CoffeeTronics/Arduino-Mass-Based-Espresso/Thermistor4cBubbleDisplay_withSignalConditioning/Eagle_Schematic/readMe.txt

Use this schematic with digitalSmooth code
