CoffeeTronics/Arduino-Mass-Based-Espresso/OldCodeFromTestingSections/MeasureVccUsingVrefBubbleDisplay/readMe.txt

This folder is depreciated. 

It was used to measure the Vcc rails of the Arduino's ADC.
This code has been merged into digitalSmooth.
The Vcc rails are measured once during setup().

The menu needs to be adapted to be able to run the Vcc Measurement periodically and
on demand.
