CoffeeTronics/Arduino-Mass-Based-Espresso/OldCodeFromTestingSections/LM35_TempReferenceBubbleDisplay/LM35_TempReferenceBubbleDisplay/readMe.txt

Use this code to calibrate the thermistor. The LM35 is guaranteed to be +/-0.5C 
(typically +/-0.2C) at 25C and +/-0.75C over full range (-55C to 150C)
