CoffeeTronics/Arduino-Mass-Based-Espresso/HX711_Brew_Switch_Preinfusion_Measure_Mass/HX711_BrewSwitchSense_Preinfusion.pdf

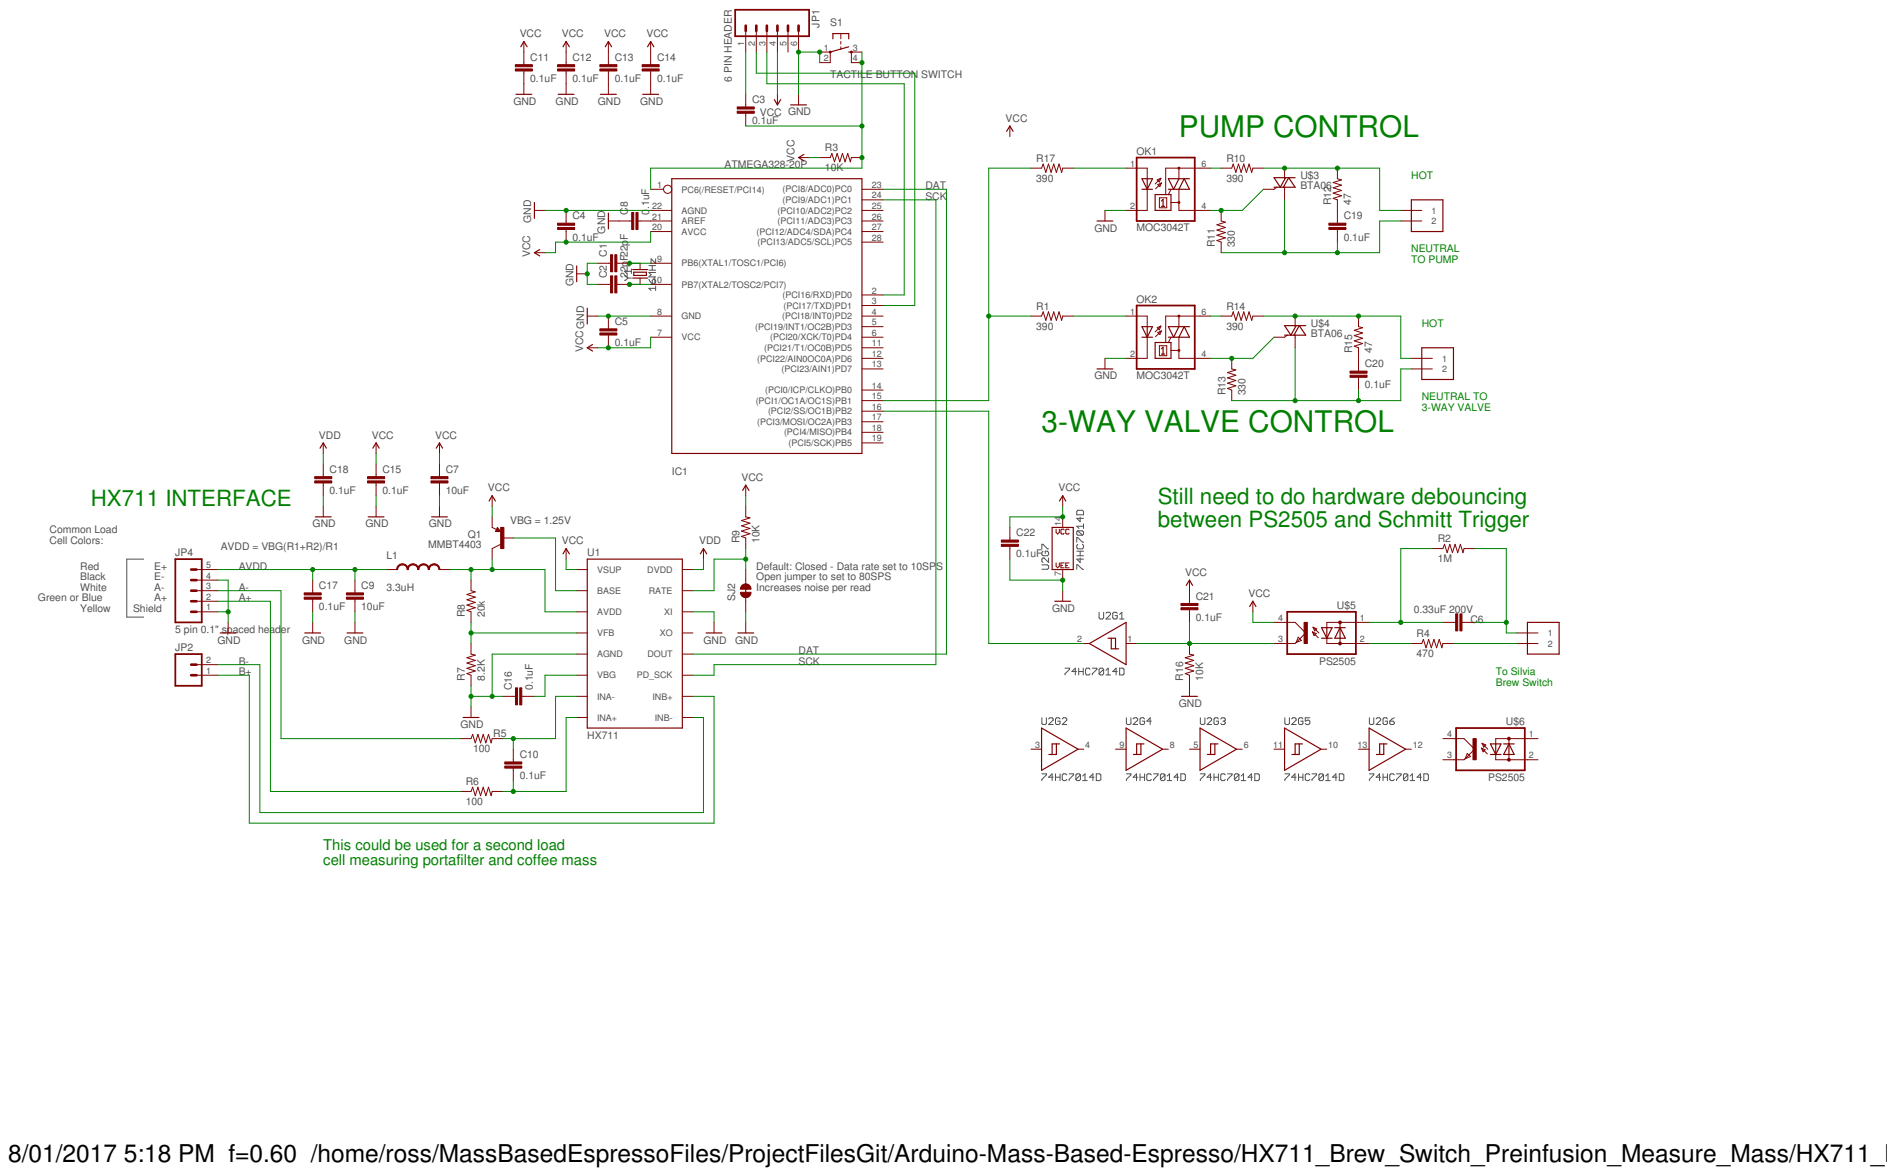
[picture p1: page 1]

VCC GND GND GND GND GND

HOT NEUTRAL TO PUMP HOT

Still need to do hardware debouncing
between PS2505 and Schmitt Trigger

Increases noise per read E+E- A- A+ Red Black White Green or Blue

To Silvia Brew Switch

This could be used for a second load
cell measuring portafilter and coffee mass

8/01/2017 5:18 PM f=0.60 /home/ross/MassBasedEspressoFiles/ProjectFilesGit/Arduino-Mass-Based-Espresso/HX711_Brew_Switch_Preinfusion_Measure_Mass/HX711_BrewSwitchSense_Preinfusion.sch (Sheet: 1/1)
