CoffeeTronics/Arduino-Mass-Based-Espresso/Thermistor4cBubbleDisplay_withSignalConditioning/Eagle_Schematic/BubbleDisplayTempSensingThermistorWithRCfilterOpampSignalConditioning.pdf

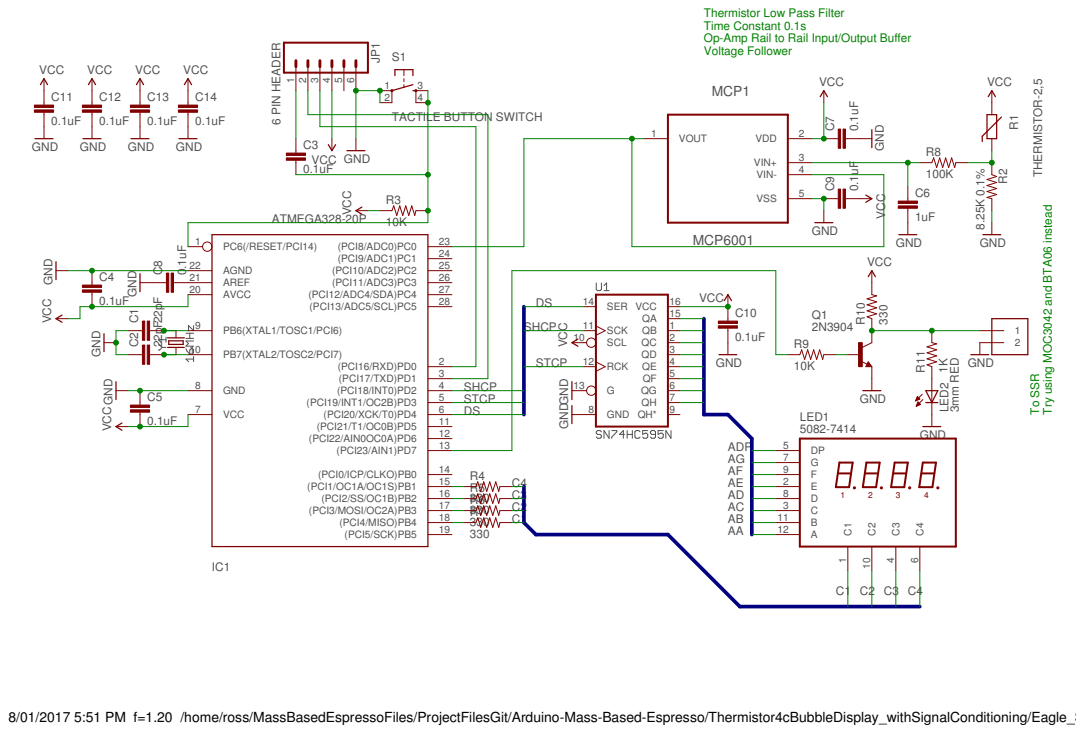
[picture p2: page 1]

Thermistor Low Pass Filter
Time Constant 0.1s
Op-Amp Rail to Rail Input/Output Buffer
Voltage Follower

8/01/2017 5:51 PM f=1.20 /home/ross/MassBasedEspressoFiles/ProjectFilesGit/Arduino-Mass-Based-Espresso/Thermistor4cBubbleDisplay_withSignalConditioning/Eagle_Schematic/BubbleDisplayTempSensingThermistorWithRCfilterOpampSignalConditioning.sch (Sheet: 1/1)
