CoffeeTronics/Arduino-Mass-Based-Espresso/RotaryEncoderLCDMenu/src/Arduino_Rotary_Encoder_Lcd_ADD-DS3231.pdf

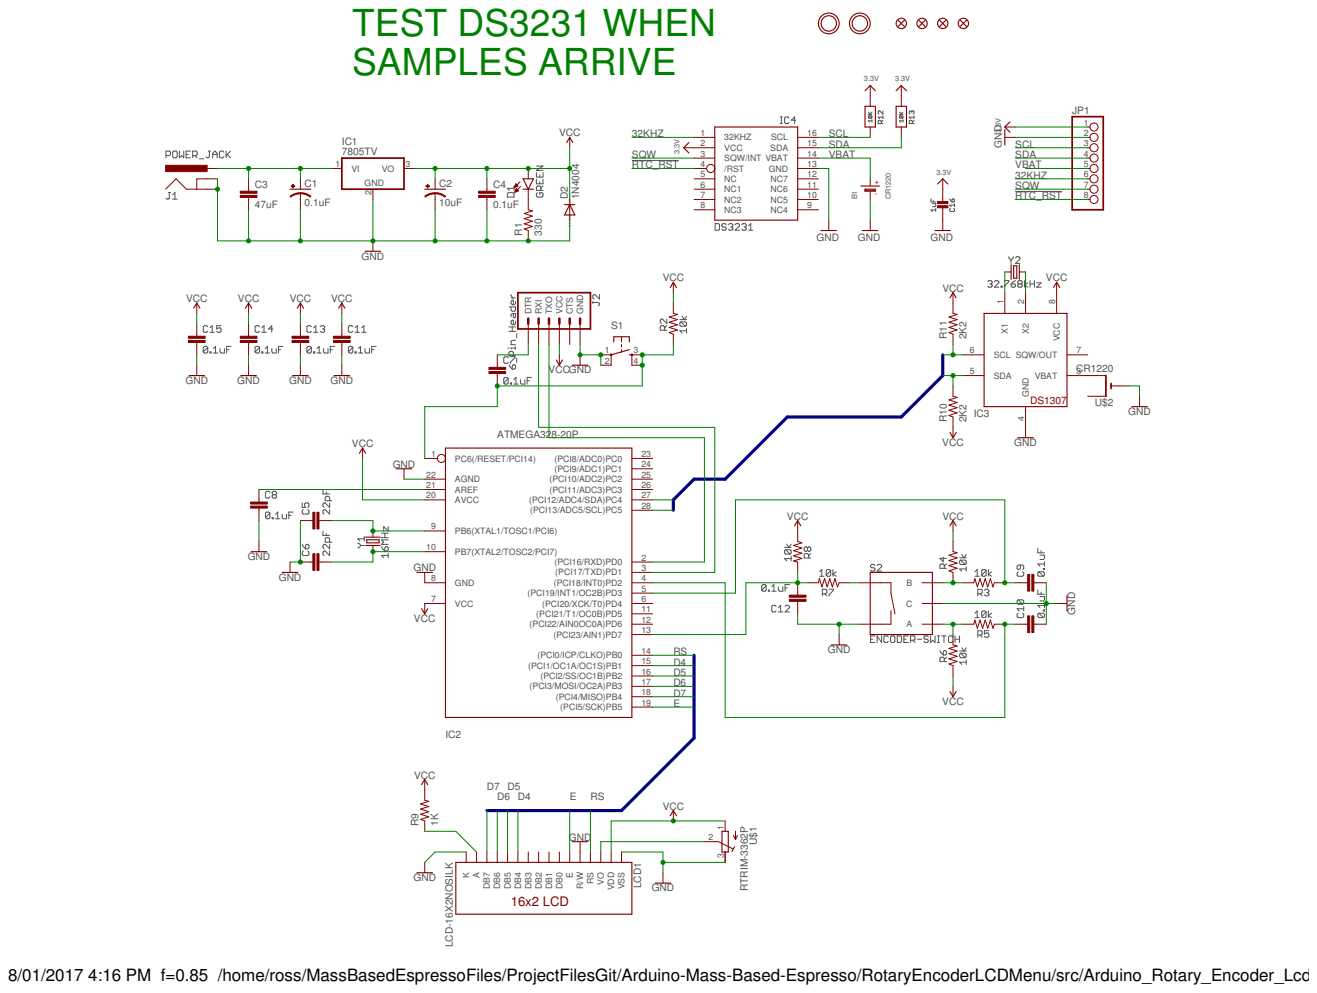
[picture p3: page 1]

8/01/2017 4:16 PM f=0.85 /home/ross/MassBasedEspressoFiles/ProjectFilesGit/Arduino-Mass-Based-Espresso/RotaryEncoderLCDMenu/src/Arduino_Rotary_Encoder_Lcd_ADD-DS3231.sch (Sheet: 1/1)
