CoffeeTronics/Arduino-Mass-Based-Espresso/DATASHEETS_APPLICATION_NOTES/SparkFun_HX711_Load_Cell_v11/SparkFun_HX711_Load_Cell_v11.brd

## EAGLE design DATASHEETS_APPLICATION_NOTES/SparkFun_HX711_Load_Cell_v11/SparkFun_HX711_Load_Cell_v11.brd (2017-01-08)

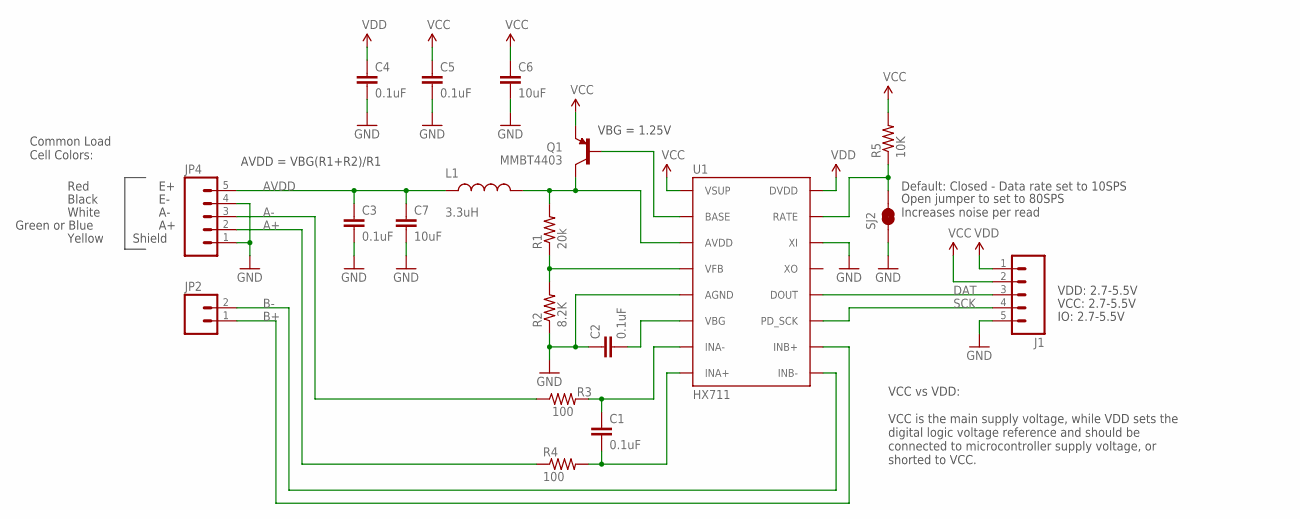
[picture p4: schematic HX711_Sparkfun.sch]

Parts:
C1, C2, C3, C4, C5: 0.1uF; 0603-CAP
C6, C7: 10uF; 1210
J1: M05PTH; 1X05
JP2: M02PTH; 1X02
JP4: M05PTH; 1X05
L1: 3.3uH; 0805
Q1: MMBT4403; SOT23-3
R1: 20k; 0603-RES
R2: 8.2K; 0603-RES
R3, R4: 100; 0603-RES
R5: 10K; 0603-RES
SJ2: JUMPER-PAD-2-NC_BY_TRACE; PAD-JUMPER-2-NC_BY_TRACE_YES_SILK
U1: HX711; SO16

Connections:
A+: JP4.2, R4.1
A-: JP4.3, R3.1
AVDD: C3.1, C7.1, JP4.5, L1.1
B+: JP2.1, U1.10 (INB+)
B-: JP2.2, U1.9 (INB-)
DAT: J1.3, U1.12 (DOUT)
GND: C2.1, C3.2, C4.2, C5.2, C6.2, C7.2, J1.5, JP4.1, JP4.4, R2.1, SJ2.1, U1.5 (AGND), U1.14 (XI)
unnamed: R5.1, SJ2.2, U1.15 (RATE)
unnamed: C1.1, R3.2, U1.7 (INA-)
unnamed: C1.2, R4.2, U1.8 (INA+)
unnamed: Q1.1 (B), U1.2 (BASE)
unnamed: L1.2, Q1.3 (C), R1.2, U1.3 (AVDD)
unnamed: R1.1, R2.2, U1.4 (VFB)
unnamed: C2.2, U1.6 (VBG)
SCK: J1.4, U1.11 (PD_SCK)
VCC: C5.1, C6.1, J1.2, Q1.2 (E), R5.2, U1.1 (VSUP)
VDD: C4.1, J1.1, U1.16 (DVDD)

Notes on the sheet:
VCC: 2.7-5.5V
VBG = 1.25V
AVDD = VBG(R1+R2)/R1
Default: Closed - Data rate set to 10SPS
Open jumper to set to 80SPS Increases noise per read
Red
Black
White
Green or Blue
Common Load Cell Colors:
IO: 2.7-5.5V
Shield
Yellow
VDD: 2.7-5.5V
VCC vs VDD: VCC is the main supply voltage, while VDD sets the digital logic voltage reference and should be connected to microcontroller supply voltage, or shorted to VCC.



Board: 2 copper layers, 30.5 x 22.9 mm, 30 parts (4 on the bottom side), 17 nets.

Other parts of the board:
FID1, FID2: FIDUCIAL1X2; FIDUCIAL-1X2
FRAME1: FRAME-LETTER; CREATIVE_COMMONS
LOGO1: SFE_LOGO_NAME_FLAME.1_INCH; SFE_LOGO_NAME_FLAME_.1
LOGO3: SFE_LOGO_FLAME.1_INCH; SFE_LOGO_FLAME_.1
STANDOFF1, STANDOFF2, STANDOFF3, STANDOFF4: STAND-OFF
U7: OSHW-LOGOS; OSHW-LOGO-S
U$1: REVISION
