CoffeeTronics/Arduino-Mass-Based-Espresso/HX711_Brew_Switch_Preinfusion_Measure_Mass/HX711_BrewSwitchSense_Preinfusion.sch

## EAGLE design HX711_Brew_Switch_Preinfusion_Measure_Mass/HX711_BrewSwitchSense_Preinfusion.sch (2017-01-09)

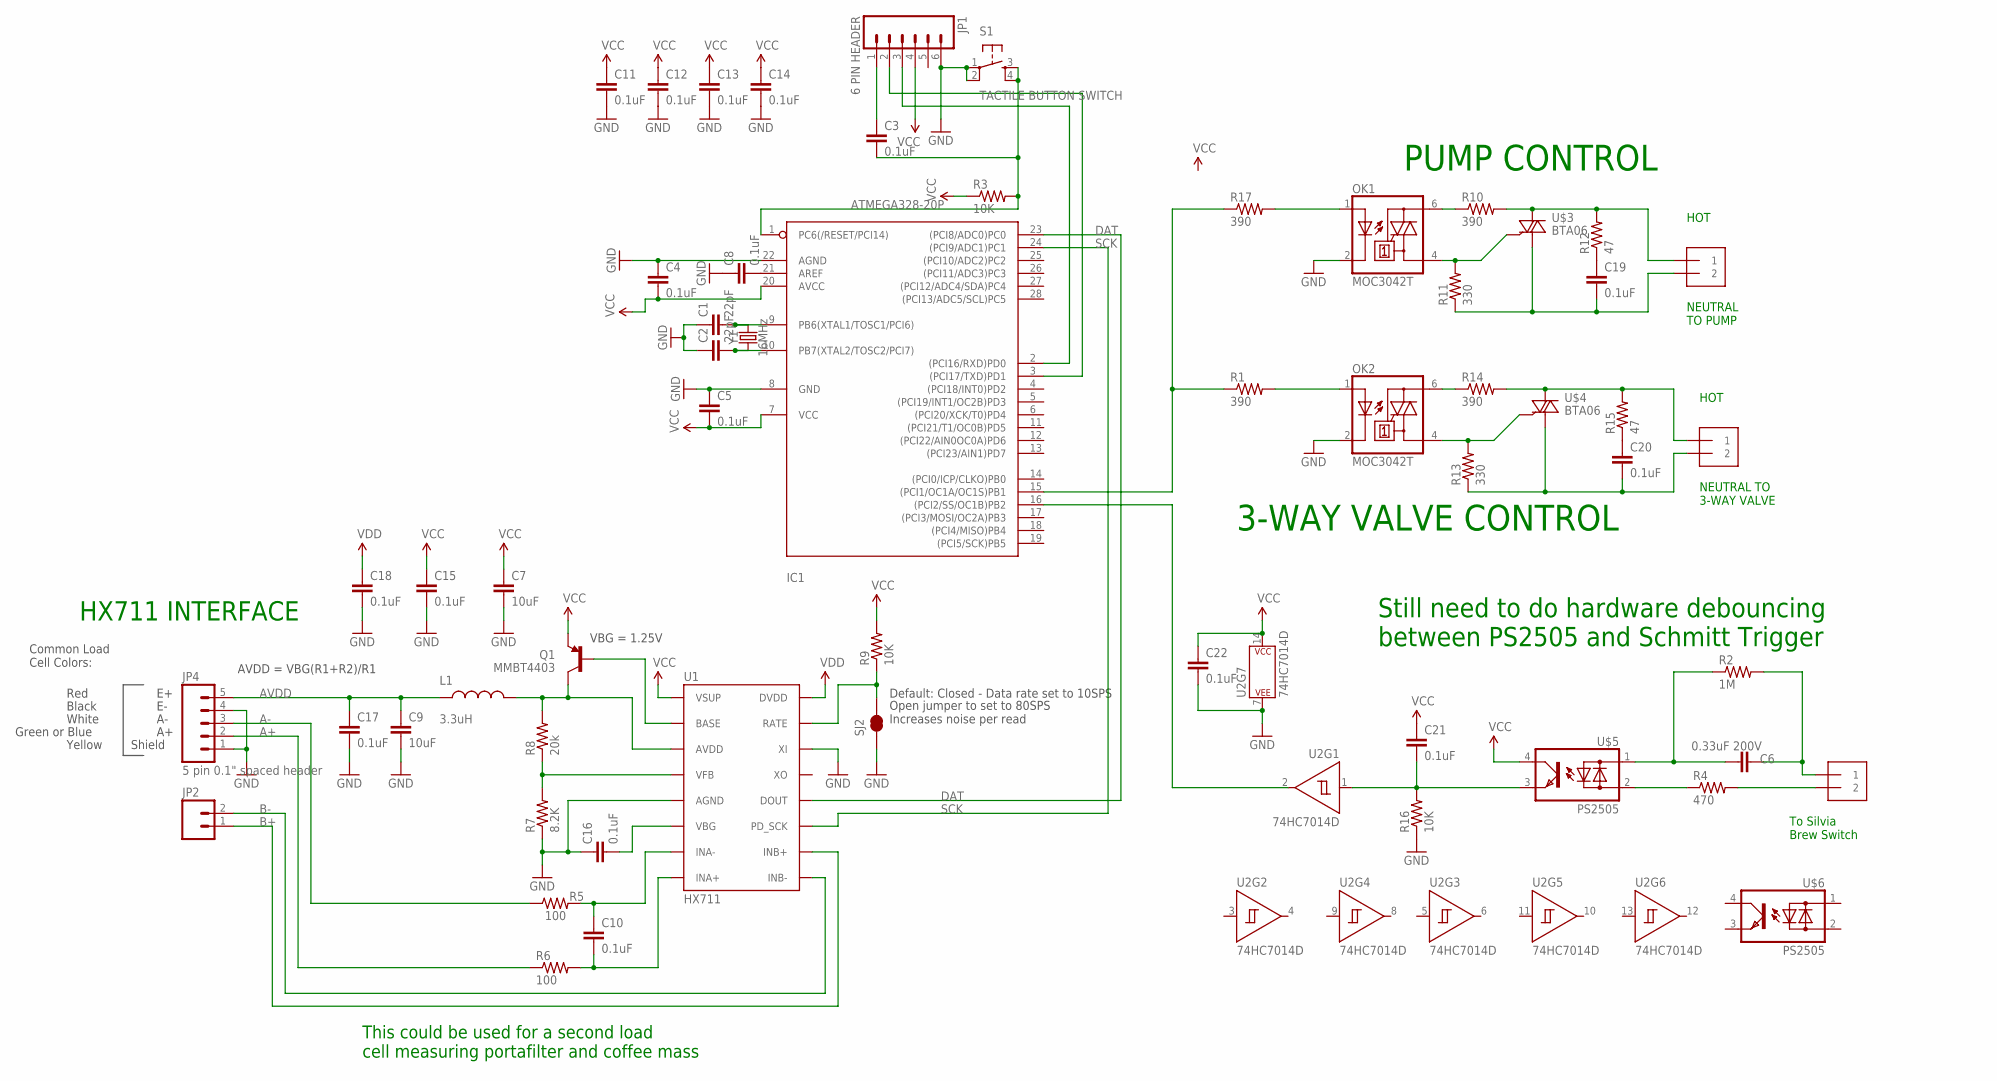
[picture p7: schematic HX711_BrewSwitchSense_Preinfusion.sch]

Parts:
C1, C2: 22pF; CAP-PTH-SMALL-KIT
C3, C4, C5, C8, C11, C12, C13, C14, C19, C20, C21, C22: 0.1uF; CAP-PTH-SMALLEZ
C6: 0.33uF 200V; C15B6
C7, C9: 10uF; 1210
C10, C15, C16, C17, C18: 0.1uF; 0603-CAP
IC1: ATMEGA328-20P; DIL28-3
J2, J3, J4: 1X2-3.5MM
JP1: 6 PIN HEADER; 1X06_LOCK_LONGPADS
JP2: M02PTH; 1X02
JP4: 5 pin 0.1" spaced header; 1X05
L1: 3.3uH; 0805
OK1, OK2: MOC3042T; DIL06B
Q1: MMBT4403; SOT23-3
R1, R10, R14, R17: 390; AXIAL-0.5
R2: 1M; 1/6W-RES
R3, R16: 10K; AXIAL-0.5
R4: 470; AXIAL-0.3-KIT
R5, R6: 100; 0603-RES
R7: 8.2K; 0603-RES
R8: 20k; 0603-RES
R9: 10K; 0603-RES
R11, R13: 330; AXIAL-0.5
R12, R15: 47; AXIAL-0.5
S1: TACTILE BUTTON SWITCH; TACTILE-PTH
SJ2: JUMPER-PAD-2-NC_BY_TRACE; PAD-JUMPER-2-NC_BY_TRACE_YES_SILK
U1: HX711; SO16
U2: 74HC7014D; SO14
U$3, U$4: BTA06; TO220V
U$5, U$6: PS2505; DIL04
Y1: 16MHz; HC49US

Connections:
A+: JP4.2, R6.1
A-: JP4.3, R5.1
AVDD: C9.1, C17.1, JP4.5, L1.1
B+: JP2.1, U1.10 (INB+)
B-: JP2.2, U1.9 (INB-)
DAT: IC1.23 ((PCI8/ADC0)PC0), U1.12 (DOUT)
GND: C1.1, C2.1, C4.1, C5.1, C7.2, C8.1, C9.2, C11.2, C12.2, C13.2, C14.2, C15.2, C16.1, C17.2, C18.2, C22.2, IC1.8 (GND), IC1.22 (AGND), JP1.6, JP4.1, JP4.4, OK1.2 (C), OK2.2 (C), R7.1, R16.P$1 (1), S1.1, S1.2, SJ2.1, U1.5 (AGND), U1.14 (XI), U2.7 (P$V-)
unnamed: C3.1, JP1.1
unnamed: OK2.1 (A), R1.P$2 (2)
unnamed: C3.2, IC1.1 (PC6(/RESET/PCI14)), R3.P$2 (2), S1.3, S1.4
unnamed: C8.2, IC1.21 (AREF)
unnamed: C1.2, IC1.9 (PB6(XTAL1/TOSC1/PCI6)), Y1.2
unnamed: C2.2, IC1.10 (PB7(XTAL2/TOSC2/PCI7)), Y1.1
unnamed: C6.1, R2.1, U$5.1 (AC1)
unnamed: C6.2, J2.1, R2.2
unnamed: IC1.3 ((PCI17/TXD)PD1), JP1.2
unnamed: IC1.2 ((PCI16/RXD)PD0), JP1.3
unnamed: R4.P$1 (1), U$5.2 (AC2)
unnamed: J2.2, R4.P$2 (2)
unnamed: Q1.1 (B), U1.2 (BASE)
unnamed: R7.2, R8.1, U1.4 (VFB)
unnamed: C16.2, U1.6 (VBG)
unnamed: L1.2, Q1.3 (C), R8.2, U1.3 (AVDD)
unnamed: R9.1, SJ2.2, U1.15 (RATE)
unnamed: C10.1, R5.2, U1.7 (INA-)
unnamed: C10.2, R6.2, U1.8 (INA+)
unnamed: IC1.15 ((PCI1/OC1A/OC1S)PB1), R1.P$1 (1), R17.P$1 (1)
unnamed: OK1.6 (A2), R10.P$1 (1)
unnamed: J3.1, R10.P$2 (2), R12.P$2 (2), U$3.2 (A2)
unnamed: OK1.4 (A1), R11.P$2 (2), U$3.3 (G)
unnamed: C19.2, J3.2, R11.P$1 (1), U$3.1 (A1)
unnamed: C19.1, R12.P$1 (1)
unnamed: C20.1, R15.P$1 (1)
unnamed: OK2.6 (A2), R14.P$1 (1)
unnamed: J4.1, R14.P$2 (2), R15.P$2 (2), U$4.2 (A2)
unnamed: OK2.4 (A1), R13.P$2 (2), U$4.3 (G)
unnamed: C20.2, J4.2, R13.P$1 (1), U$4.1 (A1)
unnamed: C21.2, R16.P$2 (2), U2.1 (A), U$5.3 (E)
unnamed: IC1.16 ((PCI2/SS/OC1B)PB2), U2.2 (Y)
unnamed: OK1.1 (A), R17.P$2 (2)
SCK: IC1.24 ((PCI9/ADC1)PC1), U1.11 (PD_SCK)
VCC: C4.2, C5.2, C7.1, C11.1, C12.1, C13.1, C14.1, C15.1, C21.1, C22.1, IC1.7 (VCC), IC1.20 (AVCC), JP1.4, Q1.2 (E), R3.P$1 (1), R9.2, U1.1 (VSUP), U2.14 (P$V+), U$5.4 (C)
VDD: C18.1, U1.16 (DVDD)

Notes on the sheet:
To Silvia Brew Switch
VBG = 1.25V
AVDD = VBG(R1+R2)/R1
Default: Closed - Data rate set to 10SPS
Open jumper to set to 80SPS Increases noise per read
Red
Black
White
Green or Blue
Common Load Cell Colors:
Shield
Yellow
HX711 INTERFACE
HOT
NEUTRAL TO PUMP
PUMP CONTROL
3-WAY VALVE CONTROL
This could be used for a second load cell measuring portafilter and coffee mass
Still need to do hardware debouncing between PS2505 and Schmitt Trigger
NEUTRAL TO 3-WAY VALVE
