CoffeeTronics/Arduino-Mass-Based-Espresso/LM35_TempReferenceBubbleDisplay/LM35_TempReferenceBubbleDisplay/LM35BubbleDisplayTempCalibration.sch

## EAGLE design LM35_TempReferenceBubbleDisplay/LM35_TempReferenceBubbleDisplay/LM35BubbleDisplayTempCalibration.sch (2016-12-26)

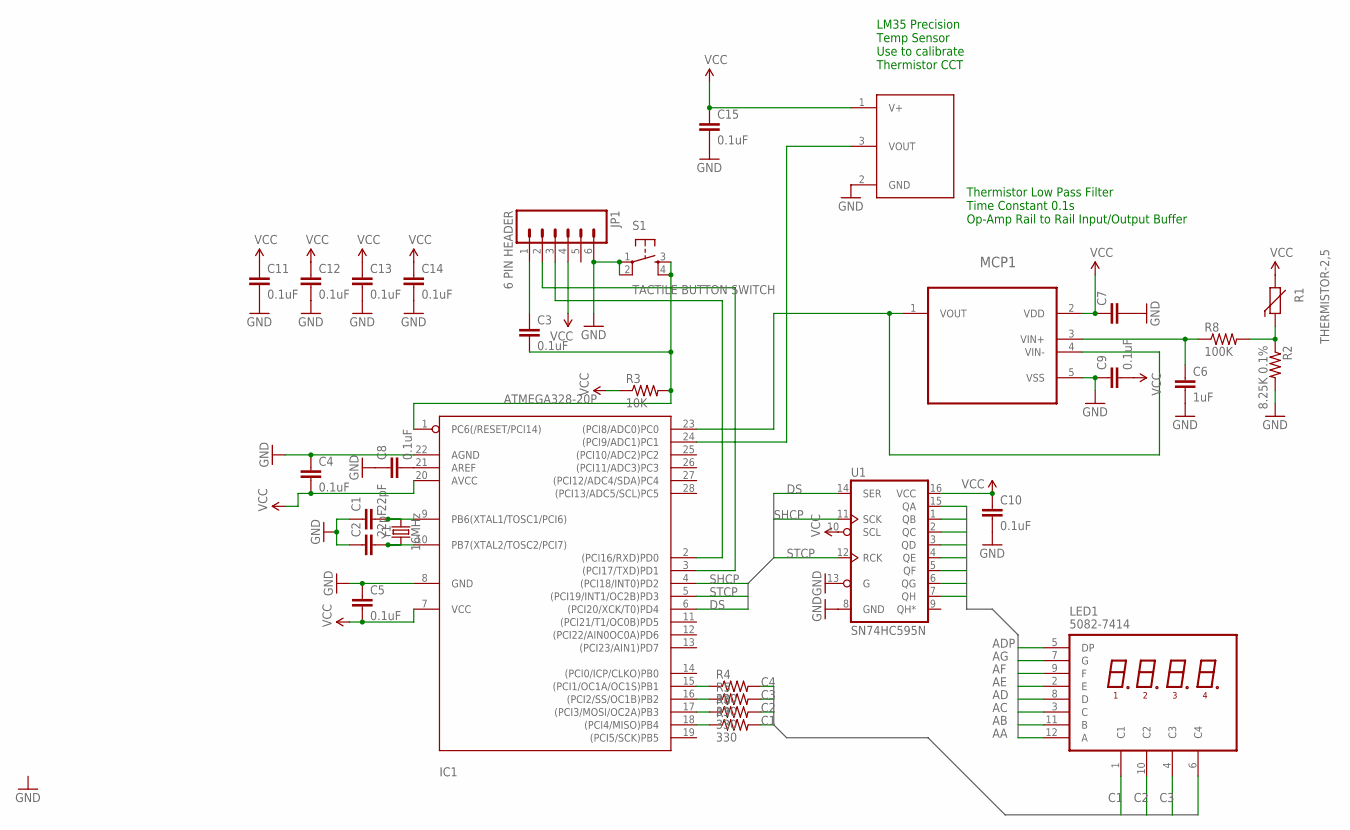
[picture p8: schematic LM35BubbleDisplayTempCalibration.sch]

Parts:
C1, C2: 22pF; CAP-PTH-SMALL-KIT
C3, C4, C5, C8, C9, C10, C11, C12, C13, C14, C15: 0.1uF; CAP-PTH-SMALLEZ
C6: 1uF; CAP-PTH-SMALLEZ
C7: CAPEZ; CAP-PTH-SMALLEZ
IC1: ATMEGA328-20P; DIL28-3
JP1: 6 PIN HEADER; 1X06_LOCK_LONGPADS
LED1: 5082-7414
MCP1: MCP6001R
R1: THERMISTOR-2,5; RS-2,5
R2: 8.25K 0.1%; AXIAL-0.5
R3: 10K; AXIAL-0.5
R4, R5, R6, R7: 330; AXIAL-0.5
R8: 100K; AXIAL-0.5
S1: TACTILE BUTTON SWITCH; TACTILE-PTH
U1: SN74HC595N; DIP16
U$1: LM35; TO220V
Y1: 16MHz; HC49US

Connections:
AA: LED1.12 (A), U1.15 (QA)
AB: LED1.11 (B), U1.1 (QB)
AC: LED1.3 (C), U1.2 (QC)
AD: LED1.8 (D), U1.3 (QD)
ADP: LED1.5 (DP), U1.7 (QH)
AE: LED1.2 (E), U1.4 (QE)
AF: LED1.9 (F), U1.5 (QF)
AG: LED1.7 (G), U1.6 (QG)
C1: LED1.1 (C1), R7.P$2 (2)
C2: LED1.10 (C2), R6.P$2 (2)
C3: LED1.4 (C3), R5.P$2 (2)
C4: LED1.6 (C4), R4.P$2 (2)
DS: IC1.6 ((PCI20/XCK/T0)PD4), U1.14 (SER)
GND: C1.1, C2.1, C4.1, C5.1, C6.2, C7.2, C8.1, C9.1, C10.2, C11.2, C12.2, C13.2, C14.2, C15.2, IC1.8 (GND), IC1.22 (AGND), JP1.6, MCP1.5 (VSS), R2.P$2 (2), S1.1, S1.2, U1.8 (GND), U1.13 (G), U$1.2 (GND)
unnamed: C3.1, JP1.1
unnamed: IC1.15 ((PCI1/OC1A/OC1S)PB1), R4.P$1 (1)
unnamed: C3.2, IC1.1 (PC6(/RESET/PCI14)), R3.P$2 (2), S1.3, S1.4
unnamed: C8.2, IC1.21 (AREF)
unnamed: C1.2, IC1.9 (PB6(XTAL1/TOSC1/PCI6)), Y1.2
unnamed: C2.2, IC1.10 (PB7(XTAL2/TOSC2/PCI7)), Y1.1
unnamed: IC1.16 ((PCI2/SS/OC1B)PB2), R5.P$1 (1)
unnamed: R1.1, R2.P$1 (1), R8.P$2 (2)
unnamed: IC1.3 ((PCI17/TXD)PD1), JP1.2
unnamed: IC1.2 ((PCI16/RXD)PD0), JP1.3
unnamed: IC1.17 ((PCI3/MOSI/OC2A)PB3), R6.P$1 (1)
unnamed: IC1.18 ((PCI4/MISO)PB4), R7.P$1 (1)
unnamed: C6.1, MCP1.3 (VIN+), R8.P$1 (1)
unnamed: IC1.23 ((PCI8/ADC0)PC0), MCP1.1 (VOUT), MCP1.4 (VIN-)
unnamed: IC1.24 ((PCI9/ADC1)PC1), U$1.3 (VOUT)
SHCP: IC1.4 ((PCI18/INT0)PD2), U1.11 (SCK)
STCP: IC1.5 ((PCI19/INT1/OC2B)PD3), U1.12 (RCK)
VCC: C4.2, C5.2, C7.1, C9.2, C10.1, C11.1, C12.1, C13.1, C14.1, C15.1, IC1.7 (VCC), IC1.20 (AVCC), JP1.4, MCP1.2 (VDD), R1.2, R3.P$1 (1), U1.10 (SCL), U1.16 (VCC), U$1.1 (V+)

Notes on the sheet:
Thermistor Low Pass Filter Time Constant 0.1s Op-Amp Rail to Rail Input/Output Buffer
LM35 Precision Temp Sensor Use to calibrate Thermistor CCT
