CoffeeTronics/Arduino-Mass-Based-Espresso/RotaryEncoderLCDMenu/src/Arduino_Rotary_Encoder_LCD.sch

## EAGLE design RotaryEncoderLCDMenu/src/Arduino_Rotary_Encoder_LCD.sch (2016-12-24)

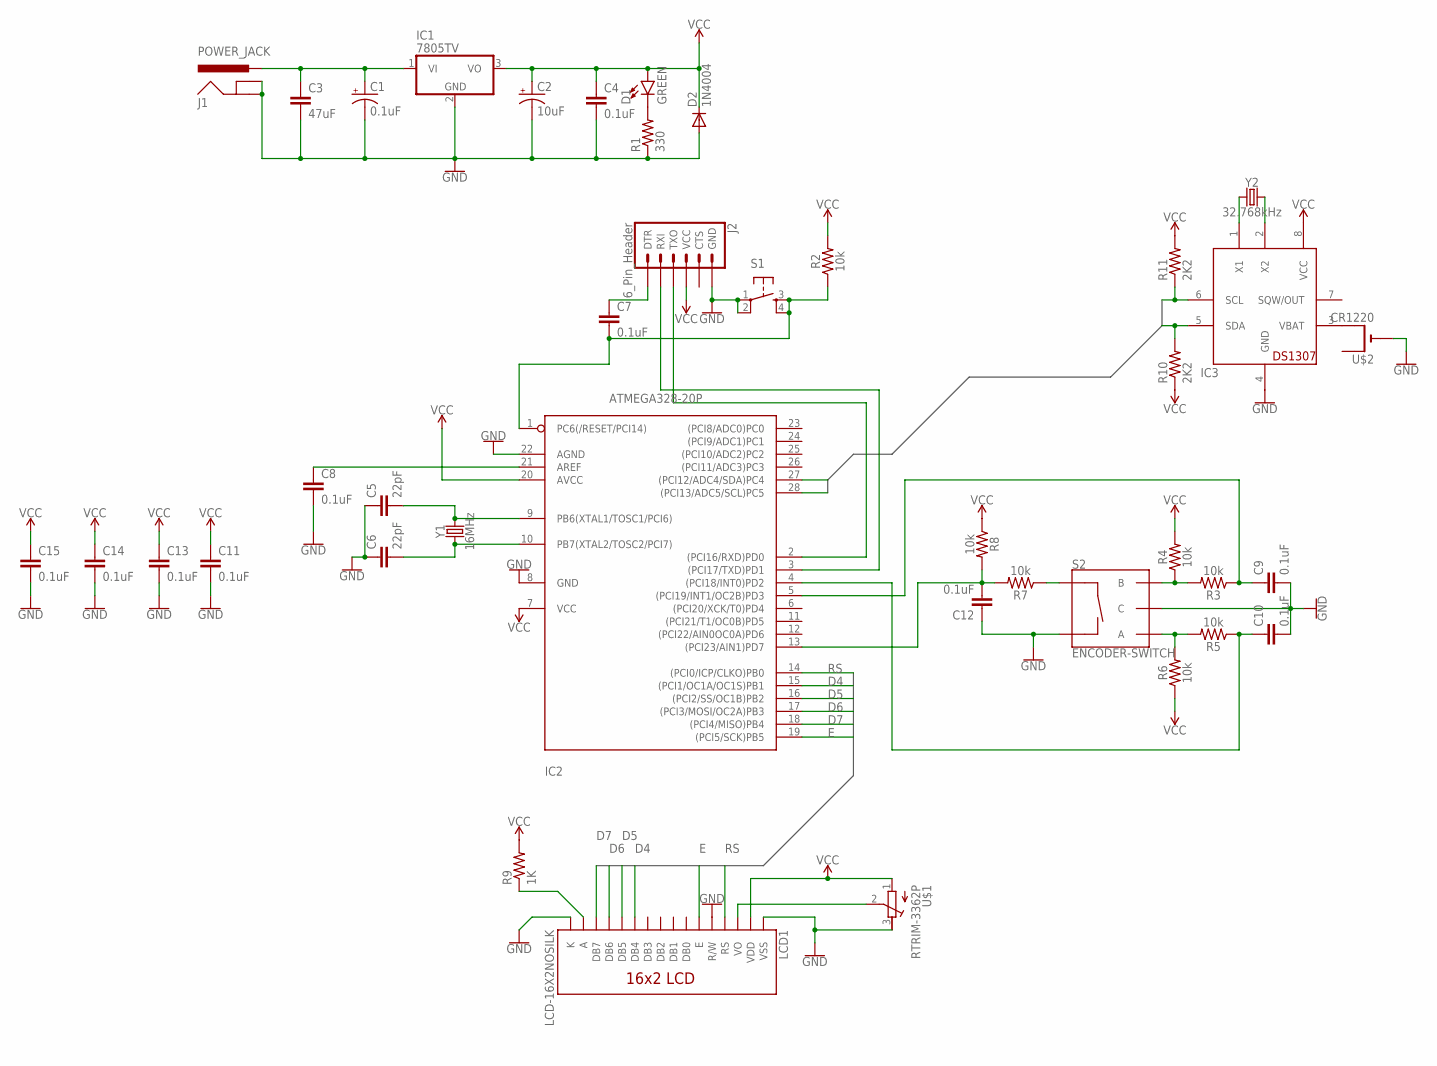
[picture p9: schematic Arduino_Rotary_Encoder_LCD.sch]

Parts:
C1: 0.1uF; CPOL-RADIAL-10UF-25V
C2: 10uF; CPOL-RADIAL-10UF-25V
C3: 47uF; CAP-PTH-SMALL
C4: 0.1uF; CAP-PTH-SMALL
C5, C6: 22pF; CAP-PTH-2.54
C7, C8, C9, C10, C11, C12, C13, C14, C15: 0.1uF; CAP-PTH-SMALL-KIT
D1: GREEN; LED_3MM
D2: 1N4004; DO41-10
IC1: 7805TV; TO220V
IC2: ATMEGA328-20P; DIL28-3
IC3: DS1307; DIL08
J1: POWER_JACK; POWER_JACK_PTH
J2: 6_Pin_Header; 1X06_LONGPADS
LCD1: LCD-16X2NOSILK; LCD-16X2_NOSILK
R1: 330; AXIAL-0.3-KIT
R2, R3, R4, R5, R6, R7, R8: 10k; AXIAL-0.3
R9: 1K; AXIAL-0.3EZ
R10, R11: 2K2; AXIAL-0.3-KIT
S1: TAC_SWITCHPTH; TACTILE-PTH
S2: ENCODER-SWITCH; ROTARY_ENC_PLAIN
U$1: RTRIM-3362P; RTRIM3362P
U$2: CR1220; CR1220-THM
Y1: 16MHz; HC49US
Y2: 32.768kHz; CRYSTAL-PTH-2X6-CYL

Connections:
D4: IC2.15 ((PCI1/OC1A/OC1S)PB1), LCD1.11 (DB4)
D5: IC2.16 ((PCI2/SS/OC1B)PB2), LCD1.12 (DB5)
D6: IC2.17 ((PCI3/MOSI/OC2A)PB3), LCD1.13 (DB6)
D7: IC2.18 ((PCI4/MISO)PB4), LCD1.14 (DB7)
E: IC2.19 ((PCI5/SCK)PB5), LCD1.6 (E)
GND: C1.2 (-), C2.2 (-), C3.2, C4.2, C5.1, C6.1, C8.2, C9.2, C10.2, C11.2, C12.1, C13.2, C14.2, C15.2, D2.A, IC1.2 (GND), IC2.8 (GND), IC2.22 (AGND), IC3.4 (GND), J1.GND, J1.GNDBREAK, J2.6 (GND), LCD1.1 (VSS), LCD1.5 (R/W), LCD1.16 (K), R1.P$1 (1), S1.1, S1.2, S2.C, S2.SW-, U$1.3, U$2.-
unnamed: C1.1 (+), C3.1, IC1.1 (VI), J1.PWR
unnamed: C5.2, IC2.9 (PB6(XTAL1/TOSC1/PCI6)), Y1.2
unnamed: C6.2, IC2.10 (PB7(XTAL2/TOSC2/PCI7)), Y1.1
unnamed: R3.P$2 (2), R4.P$1 (1), S2.B
unnamed: C8.1, IC2.21 (AREF)
unnamed: R5.P$2 (2), R6.P$2 (2), S2.A
unnamed: D1.K (C), R1.P$2 (2)
unnamed: C7.2, IC2.1 (PC6(/RESET/PCI14)), R2.P$1 (1), S1.3, S1.4
unnamed: C9.1, IC2.5 ((PCI19/INT1/OC2B)PD3), R3.P$1 (1)
unnamed: C7.1, J2.1 (DTR)
unnamed: C10.1, IC2.4 ((PCI18/INT0)PD2), R5.P$1 (1)
unnamed: IC2.3 ((PCI17/TXD)PD1), J2.2 (RXI)
unnamed: IC2.2 ((PCI16/RXD)PD0), J2.3 (TXO)
unnamed: C12.2, IC2.13 ((PCI23/AIN1)PD7), R7.P$2 (2), R8.P$2 (2)
unnamed: R7.P$1 (1), S2.SW+
unnamed: LCD1.3 (VO), U$1.2
unnamed: LCD1.15 (A), R9.P$1 (1)
unnamed: IC3.1 (X1), Y2.1
unnamed: IC3.2 (X2), Y2.2
unnamed: IC3.3 (VBAT), U$2.+2 (+1)
RS: IC2.14 ((PCI0/ICP/CLKO)PB0), LCD1.4 (RS)
SCL: IC2.28 ((PCI13/ADC5/SCL)PC5), IC3.6 (SCL), R11.P$1 (1)
SDA: IC2.27 ((PCI12/ADC4/SDA)PC4), IC3.5 (SDA), R10.P$2 (2)
VCC: C2.1 (+), C4.1, C11.1, C13.1, C14.1, C15.1, D1.A, D2.C, IC1.3 (VO), IC2.7 (VCC), IC2.20 (AVCC), IC3.8 (VCC), J2.4 (VCC), LCD1.2 (VDD), R2.P$2 (2), R4.P$2 (2), R6.P$1 (1), R8.P$1 (1), R9.P$2 (2), R10.P$1 (1), R11.P$2 (2), U$1.1
