CoffeeTronics/Arduino-Mass-Based-Espresso/(commit log)

2016-12-14 Add files via upload
    This incorporates the use of a rotary encoder with the Coagula menu.
    <http://www.coagula.org/content/pages/tutorial-manage-menu-and-lcd-display-arduino>
2016-12-15 Add files via upload
    This fixes most of the skipping problems with the rotary encoder (some hardware mods may need to me made).
    It incorporates the I2C RTC DS1307 and displays the day,date and current time.
    Rotary encoder traverses basic menu setup.
2016-12-15 Add files via upload
    This is the schematic to go with the code titled " Menu_Rotary_Encoder_RTC_Working"
    [Arduino_Rotary_Encoder_LCD.sch]
2016-12-15 Add files via upload
    Added information about the source of the rotary encoder interrupt routine
2016-12-21 Add files via upload
    Use this code to accurately measure your AVcc voltage in mV. This makes a HUGE difference to the accuracy of the thermistor readings.
2016-12-21 Add files via upload
    Use this to calibrate your temperature sensor. The LM35 has a guaranteed accuracy of +/- 0.5°C at 25°C.
    If you find you need to use a large offset to calibrate your temperature sensor, use the file "MeasureVccUsingVref" to measure your AVcc and insert that value as ThermistorInside.VoltageSupply
2016-12-21 Add files via upload
    This measures the temperature from a thermistor in a voltage divider.
    Rref was selected to maximise sensitivity at the temperature of interest 93°C
    Rref is 8.25KΩ.
    This code uses the full Steinhart-Hart equation with all 4 values for maximum accuracy across the full range of the thermistor.
    It then sends the temperature data to a 4 digit, 7 segment Bubble Display via a 74HC595 8-bit shift register.
    The temperature is displayed in Celsius and Fahrenheit for one second each.
    The thermistor currently has NO signal conditioning.
    This code is to be used with the Eagle schematic named BubbleDisplayTempSensingThermistorNoSignalConditioning.sch
2016-12-21 Add files via upload
    Use this schematic with the arduino code Thermistor4c_74HC595_Bubble_Display.
    At present there is no PID loop
    [BubbleDisplayTempSensingThermistorNoSignalConditioning.sch]
2016-12-24 Put schematic and code for rotary encoder, menu and RTC all working together
    [Arduino_Rotary_Encoder_LCD.sch]
2016-12-24 Put schematics for Thermistor and Bubble display together with relevant code
    [BubbleDisplayTempSensingThermistorNoSignalConditioning.sch]
2016-12-24 Code to precisely measure Vcc based on the internal 1.1V reference added. Need to add relevant schematic to this folder.
2016-12-24 Added code for LM35 semiconductor sensor (+/-0.5C @ 25C accuracy). Use this to calibrate thermistor sensor. Need to add relevant schematic for this code
2016-12-24 Removed extraneous files that were outside folders
    [Arduino_Rotary_Encoder_LCD.sch, BubbleDisplayTempSensingThermistorNoSignalConditioning.sch]
2016-12-24 Added RTC libraries for code
    [Arduino_Rotary_Encoder_LCD.sch, BubbleDisplayTempSensingThermistorNoSignalConditioning.sch]
2016-12-25 Removed schematic for thermistor using bubble display that had no signal conditioning. Added schematic for thermistor using bubble display that uses a RC low pass filter with a time constant of 0.1 s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
    [BubbleDisplayTempSensingThermistorWithRCfilterOpampSignalConditioning.sch]
2016-12-26 Added a JobList to outline jobs completed, to be completed and known bugs. Added schematic to show connections for LM35 temperature sensor used for calibration of the thermistor sensing circuitry. Re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
    [BubbleDisplayTempSensingThermistorWithRCfilterOpampSignalConditioning.sch, LM35BubbleDisplayTempCalibration.sch]
2017-01-07 Implemented basic I2C across all three uC's. uC#1: Only I2C updated uC#2: I2C slave sends temp to master (uC#1) once per second uC#3: I2C slave sends BrewSwitchStatus, Mass, ExtractionComplete Still 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
    [Arduino_Rotary_Encoder_Lcd_ADD-DS3231.sch, BubbleDisplayTempSensingThermistorWithRCfilterOpampSignalConditioning.sch, HX711_BrewSwitchSense_Preinfusion.sch, LM35BubbleDisplayTempCalibration.sch]
2017-01-08 Brew switch readings somewhat erroneous, currently solved in software, need to fix in hardware.Upon brew switch engaged, pump pulses twice and engages for 5 sec (demo). Sends data to I2C master, brew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
    [HX711_BrewSwitchSense_Preinfusion.sch, HX711_Sparkfun.sch, SparkFun_HX711_Load_Cell_v11.brd, SparkFun_HX711_Load_Cell_v11.sch]
2017-01-09 Updated schematics to reflect breadboard. This is to make it easier to resume work during/after semester and know what I'm up to and what needs to be done.
    [BubbleDisplayTempSensingThermistorWithRCfilterOpampSignalConditioning.sch, HX711_BrewSwitchSense_Preinfusion.sch]
