CoffeeTronics/Arduino-Mass-Based-Espresso/(notices)

Notices in the files:
RotaryEncoderLCDMenu/src/Menu_Rotary_Encoder_RTC_Working_/Menu_Rotary_Encoder_RTC_Working_/Menu_Rotary_Encoder_RTC_Working_.ino:
This program is free software: you can redistribute it and/or modify
it under the terms of the GNU General Public License as published by
the Free Software Foundation, either version 3 of the License, or
(at your option) any later version.
parts and their libraries:
SparkFun-Connectors: Licensing: CC v3.0 Share-Alike You are welcome to use this library for commercial purposes.
SparkFun-Aesthetics: Released under the Creative Commons Attribution Share-Alike 4.0 License
SparkFun-Aesthetics: https://creativecommons.org/licenses/by-sa/4.0
